markovaanastasia656-cmd/low-side-mosfet-load-driver/Anastasia_PCB_FinalProject_3Dbottom.png

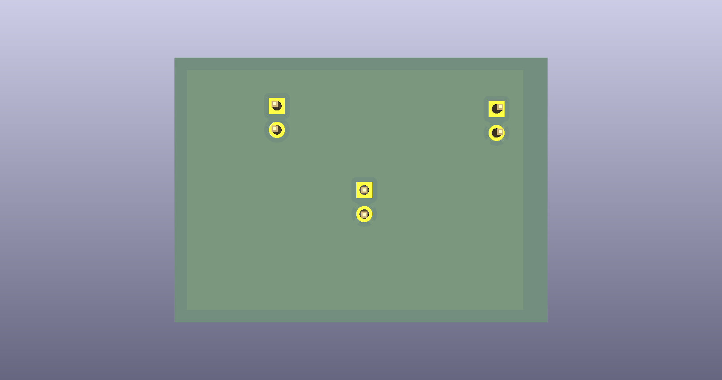
Anastasia_PCB_FinalProject_3Dbottom.png
