markovaanastasia656-cmd/low-side-mosfet-load-driver/Anastasia_PCB_FinalProject_3Dtop.png

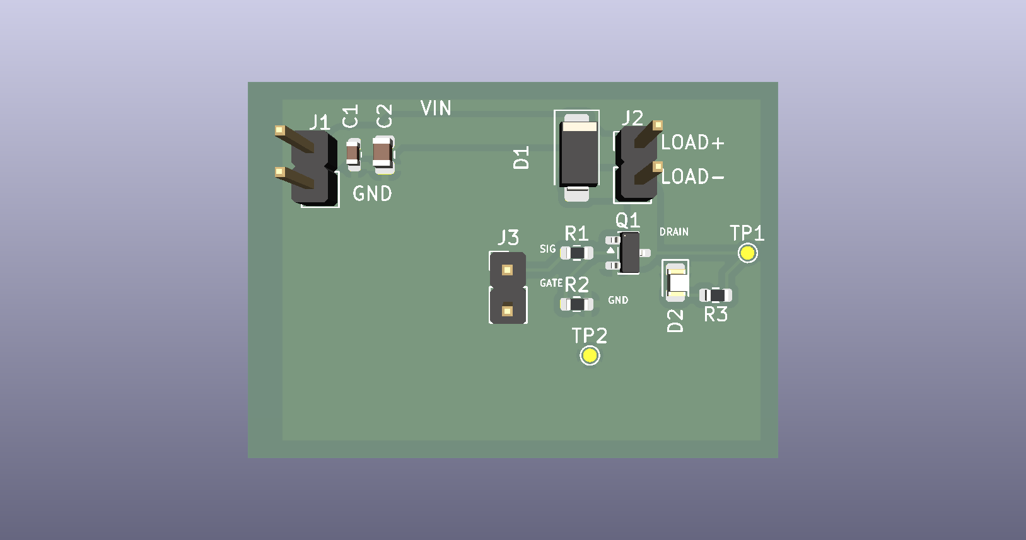
Anastasia_PCB_FinalProject_3Dtop.png
