markovaanastasia656-cmd/low-side-mosfet-load-driver/README.md

# low-side-mosfet-load-driver
A two-layer KiCad PCB implementing a logic-controlled low-side MOSFET switch for small DC loads using the AO3400A MOSFET.
