markovaanastasia656-cmd/low-side-mosfet-load-driver/Anastasia_PCB_FinalProject.kicad_pcb

## KiCad design Anastasia_PCB_FinalProject.kicad_pcb (2026-06-02)

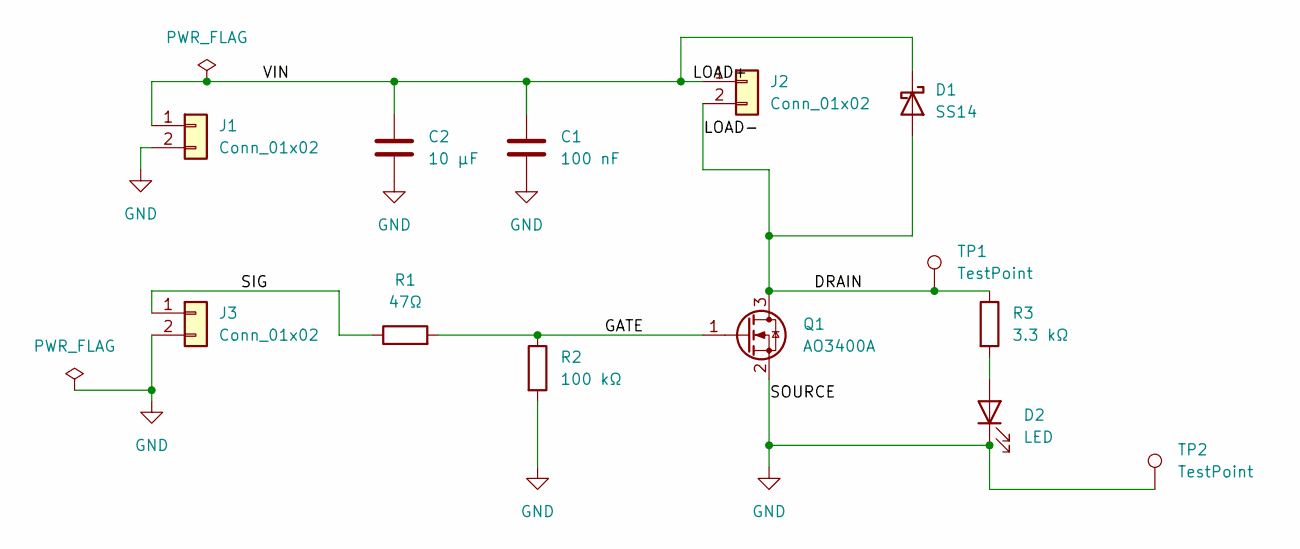
[picture p3: schematic Anastasia_PCB_FinalProject.kicad_sch]

Parts:
C1: 100 nF; C_0603_1608Metric
C2: 10 μF; C_0805_2012Metric
D1: SS14; D_SMA
D2: LED; LED_0805_2012Metric
J1, J2, J3: Conn_01x02; PinHeader_1x02_P2.54mm_Vertical
Q1: AO3400A; SOT-23
R1: 47Ω; R_0603_1608Metric
R2: 100 kΩ; R_0603_1608Metric
R3: 3.3 kΩ; R_0603_1608Metric
TP1, TP2: TestPoint; TestPoint_Pad_D1.0mm

Connections:
/DRAIN: D1.2 (A), J2.2, Q1.3 (D), R3.1, TP1.1 (1_1)
/GATE: Q1.1 (G), R1.2, R2.1
/LOAD+: C1.1, C2.1, D1.1 (K), J1.1, J2.1
/SIG: J3.1, R1.1
GND: C1.2, C2.2, D2.1 (K), J1.2, J3.2, Q1.2 (S), R2.2, TP2.1 (1_1)
unnamed: D2.2 (A), R3.2

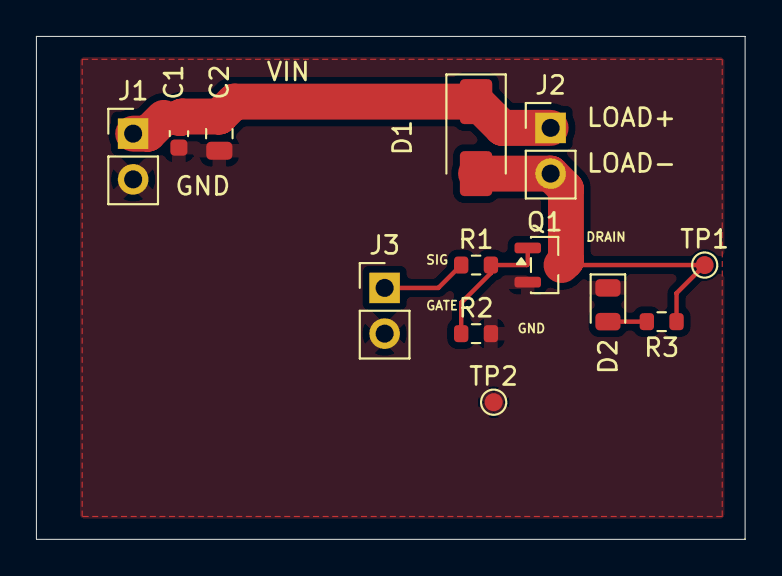
[picture p4: board Anastasia_PCB_FinalProject.kicad_pcb from above]

Board: 2 copper layers, 39.4 x 27.9 mm, 13 parts (0 on the bottom side), 6 nets.
